NMRL24/Braille-Based-IoT-Home-Automation-for-Multi-Disability-Empowerment/README.md

# 🏠 Braille-Based IoT Home Automation  
### ♿ Empowering Multi-Disability Accessibility
https://www.ijert.org/research/braille-based-iot-home-automation-system-for-visually-impaired-users-using-esp32-microcontroller-IJERTV15IS030861.pdf
---
# 👨‍💻 **TEAM DETAILS** ⭐

### 🧑‍🎓 Project Members:
- ****N. Manikanta Raghava****  (Team Lead)
- **M. Jahnavi**  
- **N. Venkata Siva Prasanth**  
- **Md. Habeeb Pasha**  

### 🎓 Course:
**B.Tech – Electronics and Communication Engineering**

### 🏫 Institution:
**Seshadri Rao Gudlavalleru Engineering College**  
(Affiliated to JNTU Kakinada)

### 👨‍🏫 Project Guide:
**Mr. V. Vittal Reddy**  
*(Associate Professor, ECE Department)*  
## 📌 Project Overview
This project presents an **assistive smart home system** designed for **visually impaired users**, enabling them to control home appliances using a **Braille-based tactile interface**.

Unlike traditional systems that depend on screens or voice commands, this solution provides a **completely sight-independent interaction model** using **ESP32 and IoT technology**.

---

## 🚀 Key Features
- 🔤 **Braille Input System** (6-button tactile interface)  
- 📡 **Wi-Fi Based Communication (TCP/IP)**  
- 📱 **Blynk IoT Integration for Remote Monitoring**  
- 🔔 **Audio + Vibration Feedback System**  
- 🔥 **Dual-Sensor Fire Detection (MQ-2 + IR Flame)**  
- 🔐 **Password-Protected Door Lock (Servo Motor)**  
- 💡 **Appliance Control (Lights, Fan with Speed Control)**  
- ⚡ **Works even without Internet (AP + STA Mode)**  

---

## 🏗️ System Architecture

---

## 🧰 Hardware Components
- ESP32-WROOM-32 (×2)  
- 8-Channel Relay Module  
- TTP223 Touch Sensors  
- MQ-2 Gas Sensor  
- IR Flame Sensor  
- SG90 Servo Motor  
- OLED Display (SSD1306)  
- Push Buttons (Braille Input)  
- Buzzer & Vibration Motor  
- Power Supply Module  

---

## 💻 Software Used
- Arduino IDE  
- Embedded C/C++  
- Blynk IoT Platform  
- TCP/IP Communication  

---

## 🔄 Working Principle
1. User inputs command via **Braille keypad**  
2. ESP32 converts it into **ASCII command**  
3. Command is sent via **Wi-Fi (TCP protocol)**  
4. Appliance module executes action  
5. Feedback is provided via **buzzer & vibration**  
6. Status is updated on **Blynk App**  

---

## 📊 Results
- ⚡ Fast response (~350 ms)  
- 🔐 Reliable & secure system  
- 🔥 Accurate fire detection with minimal false alarms  
- 📡 Stable IoT communication  

---

## 🌟 Advantages
- Fully **accessible for visually impaired users**  
- **Low-cost & scalable**  
- **Real-time monitoring & alerts**  
- **Independent operation without internet**  

---

## 🔮 Future Scope
- Wearable **Braille smart glove**  
- Braille-to-voice conversion  
- AI-based automation  
- Mobile accessibility enhancements  

---

## ⭐ Support
If you like this project, give it a ⭐ on GitHub!
