NMRL24/Braille-Based-IoT-Home-Automation-for-Multi-Disability-Empowerment/LIST OF FIGURES.docx

LIST OF FIGURES

Figure No. | Title | Page No.
Figure 1.1 | The Braille dot mapping used to represent English characters, symbols, and numbers | 4
Figure 3.1 | Architectural Block Diagram of the Braille-Based IoT Home Automation System | 8
Figure 3.2 | ESP32-WROOM-32 Microcontroller Module | 10
Figure 3.3 | ESP32 Access Point (AP) and Station (STA) Modes | 11
Figure 3.4 | ESP32-WROOM-32 Pinout | 12
Figure 3.5 | MB102 Breadboard Power Supply Module | 14
Figure 3.6 | 8-Channel Opto-Isolated Relay Module | 14
Figure 3.7 | Multi-Step Capacitive Reactance Based AC Voltage Regulator | 15
Figure 3.8 | TTP223 Capacitive Touch Sensor Module | 16
Figure 3.9 | MQ-2 Gas Sensor | 16
Figure 3.10 | Infrared (IR) Obstacle Avoidance Sensor | 17
Figure 3.11 | SG90 Micro Servo Motor | 18
Figure 3.12 | 0.96-inch OLED Display | 18
Figure 3.13 | DPST (Double Pole Single Throw) Rocker Switch | 19
Figure 3.14 | 6mm Momentary Tactile Push Button | 20
Figure 3.15 | Active Piezoelectric Buzzer | 20
Figure 3.16 | 2N2222 NPN Transistor Driver-based Vibration Motor | 21
Figure 4.1 | Firmware Execution Flow for both ESP32 Modules | 22
Figure 4.2 | The Braille Keypad Module prototype showing the six-button row, the two TTP223 capacitive touch pads, the buzzer, and the vibration motor mounted on perfboard. | 24
Figure No. | Title | Page No.
Figure 4.3 | The Appliance Control Module prototype showing the relay board, connected room lights and fans, servo-operated door lock, IR flame sensor, MQ-2 gas sensor, and OLED status display. | 30
Figure 4.4 | Schematic of Capacitor-Based Fan Speed Regulation Circuit | 33
Figure 4.5 | Password Entry Circuit using Touch Sensor and Push-Button | 36
Figure 5.1 | Appliance control module response for command L1 | 40
Figure 5.2 | Hardware output showing fan1 at regulation level 1 | 41
Figure 5.3 | Hardware output showing setting fan1 to regulation level 2 | 41
Figure 5.4 | Stimulating fire monitoring system | 42
Figure 5.5 | sending Acknowledgment(ACK) signal | 42
Figure 5.6 | Push notification on the Blynk IoT app | 43
Figure 5.7 | Dashboard interface for the Braille Assistive Home IoT project, displaying the real-time status of Light 1 | 43
Figure 5.8 | Dashboard interface for the Braille Assistive Home IoT project, displaying the real-time status of fan 1 regulation level at level 1 | 44
Figure 5.9 | Dashboard interface for the Braille Assistive Home IoT project, displaying the real-time status of fan 1 regulation level at level 2 | 44
Figure 5.10 | OLED display transitions showing (left) the typed password being validated as correct and (right) the resulting "ACCESS GRANTED" message. | 45
Figure 5.11 | OLED display transitions showing (left) the typed password being validated as incorrect and (right) the resulting "ACCESS DENIED" error message. | 45
Figure A.1 | QR Code for Accessing Source Code of Braille keypad module through GitHub Repository | 53
Figure A.2 | QR Code for Accessing Source Code of Appliance control module through GitHub Repository | 53
Figure B.1 | QR Code for Accessing "Braille-Based IoT Home Automation System for Visually Impaired Users using ESP32 Microcontroller" – Published in IJERT, Vol. 15, Issue 03, March 2026 | 54

LIST OF TABLES

Table No. | Title | Page No.
Table 3.1 | ESP32-WROOM-32 Developmental Board Pin Configuration and Functionality | 12
Table 4.1 | Feedback Pattern Encoding — Buzzer and Vibration Motor | 29
Table 4.2 | Supported Command Set with Executed Actions | 31
Table 4.3 | Capacitor-Based Fan Speed Regulation Relay and Capacitance Mapping | 33

ABSTRACT

This project presents a specialized assistive technology enabling visually impaired users to independently and securely control their domestic environment. Conventional smart home interfaces—relying on high-resolution touchscreens or voice recognition—frequently fail the blind community due to visual dependency or unreliability in noisy environments. To overcome these limitations, a tactile-first control paradigm is introduced, grounded in the universal six-dot Braille code, the global standard for tactile literacy.

The system employs a decentralized dual-module architecture using two ESP32-WROOM-32 microcontrollers. The Braille Keypad Module features a six-pushbutton array replicating a Braille cell layout, converting user-entered Braille patterns into ASCII commands. To handle overlapping patterns shared between letters (A–J) and numerals (1–0), two TTP223 capacitive touch sensors act as mode selectors—left for numeric input, right for alphabetic—while simultaneous activation of both confirms and transmits the command over a persistent TCP/IP connection.

The Appliance Control Module serves as the execution hub, managing room lighting, ceiling fan speed via a four-step capacitor-based circuit, and a secure door lock simulated by a high-torque servo motor. Safety is paramount: a dual-sensor fire detection loop combining an IR flame sensor and an MQ-2 gas sensor requires both sensors to simultaneously exceed their thresholds before triggering an alert, effectively eliminating false positives caused by sunlight or incandescent bulbs.

A multi-modal feedback system employing distinct haptic vibration and auditory beep patterns—short pulses for success, long pulses for errors, and continuous vibrations for emergencies—ensures users receive real-time confirmation at every interaction. Remote monitoring is facilitated via the Blynk IoT platform, whereby caretakers receive push notifications only after an on-site user physically acknowledges an emergency, keeping the user central to the automation loop and harmonizing traditional tactile methods with modern IoT connectivity.

Key Words: Braille Tactile Interface, IoT Assistive Technology, Visually Impaired Home Control, ESP32 Microcontroller, Dual-Sensor Fire Detection, Multi-modal Feedback, TCP/IP Communication, Blynk Cloud Integration.

Electronics and Communication engineering 2025-2026

Braille-Based IoT Home Automation for Multi-Disability Empowerment 2
