NMRL24/Braille-Based-IoT-Home-Automation-for-Multi-Disability-Empowerment/TABLE OF CONTENTS.docx

CONTENTS

Title | Page No.
List of Figures | i
List of Tables | iii
Abstract | iv
CHAPTER 1: INTRODUCTION TO BRAILLE-BASED IOT HOME AUTOMATION | 1
1.0 Introduction | 1
1.1 Background | 1
1.2 Aim of the Project | 1
1.3 Methodology | 2
1.4 Significance | 4
1.5 Organization of Project | 5
CHAPTER 2: LITERATURE SURVEY | 6
2.0 Introduction | 6
2.1 Problem Statement | 6
2.2 Comparative Analysis of Existing Digital-Tactile Interfaces and Smart Home Platforms | 6
2.3 Proposed System | 7
CHAPTER 3: SYSTEM ARCHITECTURE AND HARDWARE COMPONENTS | 8
3.0 Introduction | 8
3.1 System Architecture | 8
3.2 Hardware Components | 9
A. ESP32-WROOM-32 | 9
B. MB102 Breadboard Power Supply Module | 13
C. 8-Channel Active-Low Relay Board | 14
D. Capacitive Fan Speed Regulator Circuit | 15
E. TTP223 Capacitive Touch Sensor | 16
F. MQ-2 Gas Sensor | 16
G. IR Flame Sensor | 17
H. SG90 Micro Servo Motor | 17
I. SSD1306 0.96" OLED Display | 18
J. Manual Rocker/Toggle Switches (KCD4) | 19
K. Tactile Pushbuttons | 20
L. Active Piezo Buzzer | 20
M. Vibration Motor (ERM) | 21
CHAPTER 4: IMPLEMENTATION OF THE BRAILLE BASED IOT HOME AUTOMATION | 22
4.0 Introduction | 22
4.1 Firmware Execution Flow | 22
4.2 Braille Keypad Module | 24
4.2.1 Six-Button Braille Input Array | 24
4.2.1.1 Hardware Construction | 24
4.2.1.2 Braille Encoding and Character Decoding Logic | 25
4.2.1.3 Command Buffer and Transmission Behaviour | 26
4.2.2 TTP223 Capacitive Touch Sensors | 26
4.2.2.1 Hardware | 26
4.2.2.2 Five-Gesture Vocabulary | 27
4.2.2.3 Emergency Mode Behaviour in Firmware | 27
4.2.3 Buzzer and Vibration Motor Feedback Subcircuit | 28
4.2.3.1 Hardware | 28
4.2.3.2 Feedback Pattern Encoding | 28
4.2.4 Wi-Fi Station Link and TCP Client Connection | 29
4.3 Appliance Control Module | 30
4.3.1 TCP Server and Command Parsing | 30
4.3.1.1 Server Initialisation and Client Management | 30
4.3.1.2 Command Reception and Parsing | 31
4.3.2 Room Light Control Subcircuit | 32
4.3.3 Capacitor-Based Fan Speed Regulation Circuit | 32
4.3.3.1 Hardware Principle | 32
4.3.3.2 Relay Allocation and Capacitance Mapping | 33
4.3.3.3 Firmware Implementation | 34
4.3.4 Servo Motor Door Lock | 34
4.3.5 Dual-Sensor Fire Detection Circuit | 35
4.3.5.1 Sensor Hardware and Polarity | 35
4.3.5.2 Dual-Trigger Requirement and False-Alarm detection | 35
4.3.5.3 MQ-2 Warm-Up Limitation | 36
4.3.6 Hardware Password Entry Circuit | 36
4.3.7 Manual Override Switches | 37
4.3.8 OLED Status Display | 37
4.3.9 Blynk Cloud Integration and State Synchronisation | 38
4.3.10 Non-Volatile State Persistence | 39
CHAPTER 5: RESULTS | 40
5.0 Introduction | 40
5.1 Appliance Control Results | 40
5.1.1 Light 1 Response for Command L1 | 40
5.1.2 Fan 1 response for Command F11 | 41
5.1.3 Fan 1 response for Command F12 | 41
5.2 Fire Monitoring and IoT Integration Results | 42
5.2.1 Fire Monitoring Results | 42
5.2.2 IoT Integration Results | 43
5.2.2.1 Light 1 Status Monitoring with Command L1 | 43
5.2.2.2 Fan 1 Status Monitoring with Command F11 | 44
5.2.2.3 Fan 1 Status Monitoring with Command F12 | 44
5.3 Password Circuit Results | 45
5.3.1 Entering Correct Password | 45
5.3.2 Entering Incorrect Password | 45
CHAPTER 6: CONCLUSION AND FUTURE SCOPE | 46
6.0 Introduction | 46
6.1 Conclusion | 46
6.2 Future Scope | 46
References | 47
Classification of Project | 48
Project Outcomes Mapped with Programme Outcomes and Programme Specific Outcomes | 49
Appendix A | 53
Appendix B | 54
