NMRL24/Braille-Based-IoT-Home-Automation-for-Multi-Disability-Empowerment/images/appliance controll module.png

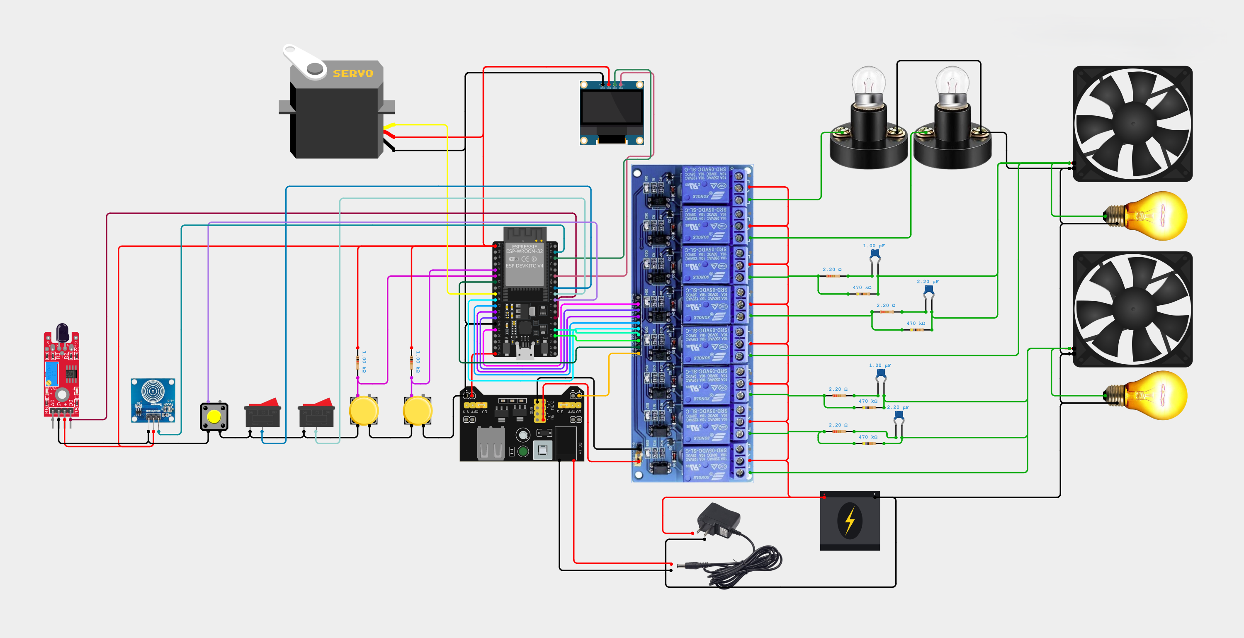
images/appliance controll module.png
