NMRL24/Braille-Based-IoT-Home-Automation-for-Multi-Disability-Empowerment/images/braille key-pad module.png

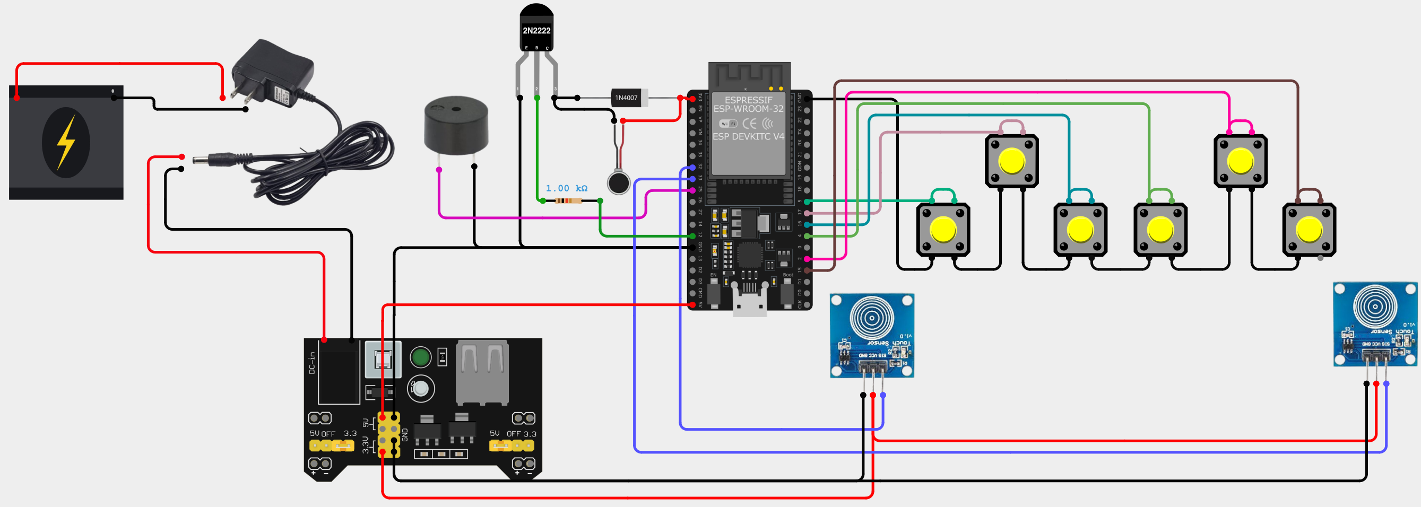
images/braille key-pad module.png
