NMRL24/Braille-Based-IoT-Home-Automation-for-Multi-Disability-Empowerment/ijert_journal_publishing/PUBLISHED/IJERTV15IS030861_Certi_A1.pdf

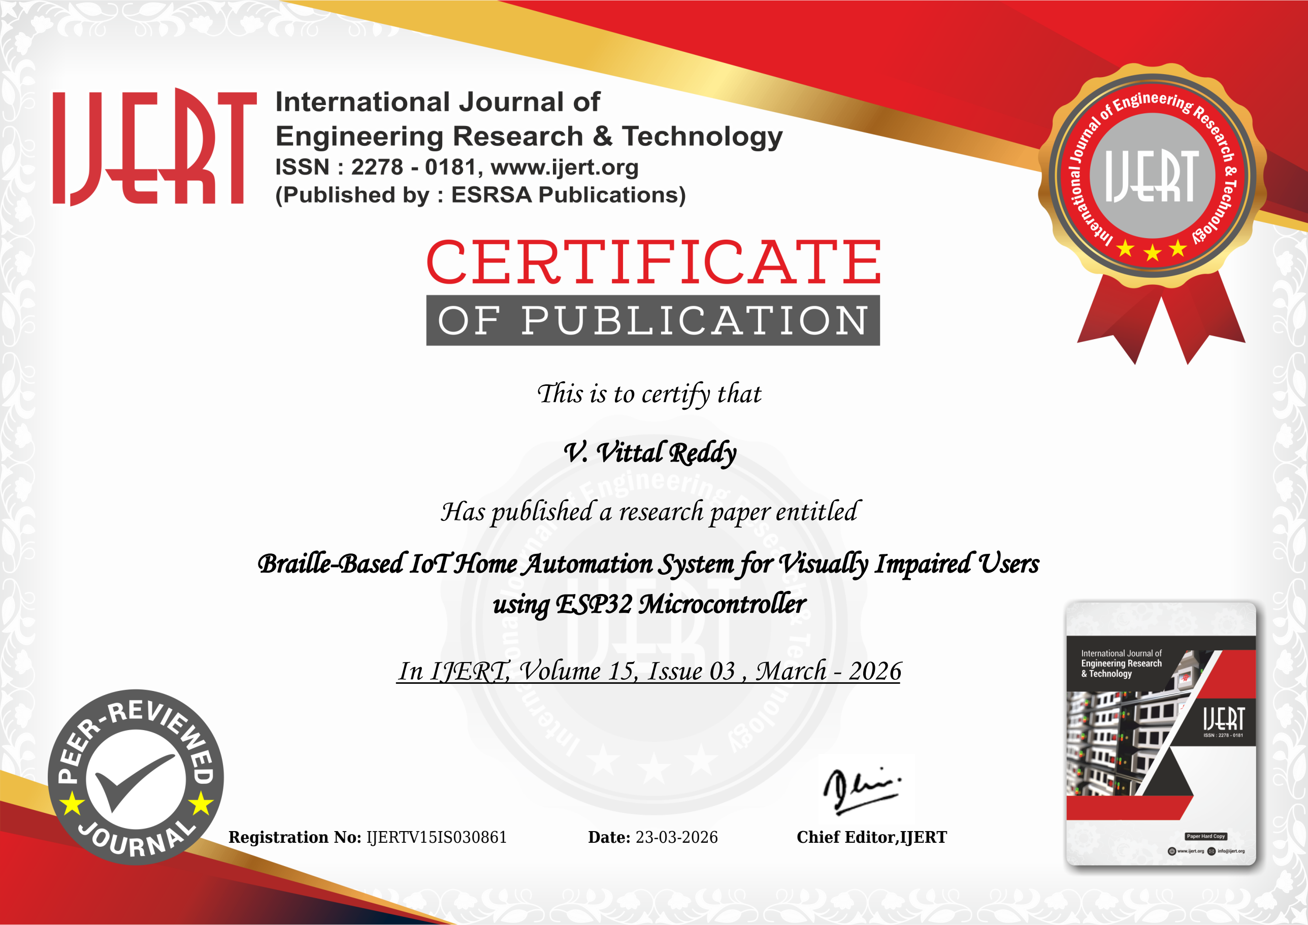
[picture p78: page 1]

This is to certify that

V. Vittal Reddy

Has published a research paper entitled Braille-Based IoT Home Automation System for Visually Impaired Users using ESP32 Microcontroller

In IJERT, Volume 15, Issue 03 , March - 2026

Registration No: IJERTV15IS030861 | Date: 23-03-2026 | Chief Editor,IJERT
