NMRL24/Braille-Based-IoT-Home-Automation-for-Multi-Disability-Empowerment/ijert_journal_publishing/Braille-Based IoT Home Automation System ijert payment reciept.jpeg

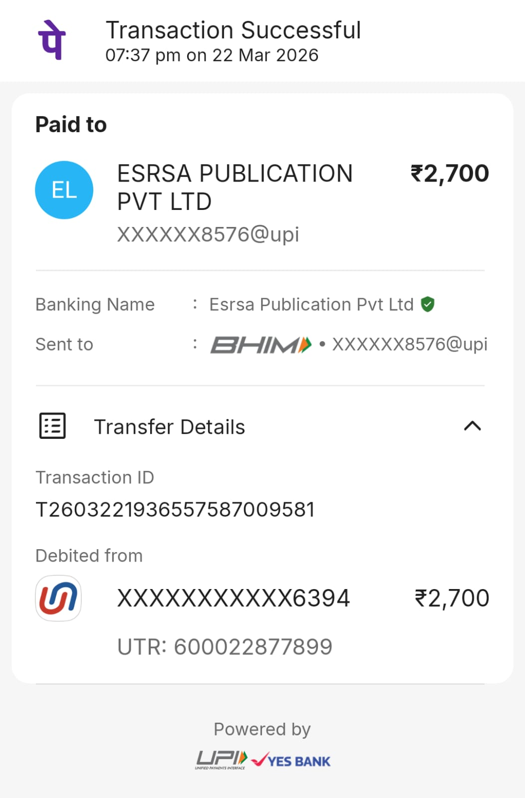
ijert_journal_publishing/Braille-Based IoT Home Automation System ijert payment reciept.jpeg
